alexanderhay2020/499/schedule.md

### Week 1<br>
<sup>1/5 - 1/11</sup>

Actuator research

### Week 2<br>
<sup>1/12 - 1/18</sup>

**COMPLETED**<br>
* Purchased actuators (x2) ETA 1/20
* Contacted manf. for part model, received .STEP 1/15
* Installed VM + Solidworks 1/16
* Initial sketch & math

**TO DO**<br>
* Begin CAD model

### Week 3<br>
<sup>1/19 - 1/25</sup>

**GOAL**
* Test actuator
* Begin CAD model

**COMPLETED**
* Test Actuator
* Initial CAD model

**IN PROGRESS**
* Refining CAD Model

**TO DO**
* Test 2 actuators

### Week 4<br>
<sup>1/26 - 2/1</sup>

**GOAL**
* Test actuator
* Continue CAD model

**COMPLETED**
* Ordering

**IN PROGRESS**
* Refining CAD Model
* Testing

###### Reach
design elbow angle detector

### Week 5<br>
<sup>2/2 - 2/8</sup>

**GOAL**
* Research rotary encoders
* CAD redesign for laser cutter
* Laser cutter training

**COMPLETED**
* Ordered rotary encoder
* Laser cutter training

**IN PROGRESS**
* Mechanical design - elbow

###### Reach
collect EMG data from myo

### Week 6<br>
<sup>2/9 - 2/15</sup>

note: EMG aspect scraped

**GOAL**
 * GET IT TO MOVE
 * Fix shorting issue

**COMPLETED**
 * Bearing install
 * Shaft install
 * Replaced rotary encoder (ordered wrong one)

 **IN PROGRESS**
 * Shaft collar design
 * Actuator/Collar connection
 * Lengthen frame to fit bicep/brac

### Week 7<br>
<sup>2/16 - 2/22</sup>

**GOAL**
 * Get it to move

**COMPLETED**
 * Frame lengthened
 * Hardware replaced to accommodate new material & manf. process
 * Replaced washers with plastic spacers (shorting issue)
 * Got it to move

**IN PROGRESS**
* Power Supply
* Actuator/Collar connection
* Replace rotary encoder (digikey mislabeled)

### Week 8<br>
<sup>2/23 - 2/29</sup>

**GOAL**
 * Create Circuit Diagram
 * Find Power Supply
 * Update github/portfolio

**COMPLETED**
 * Circuit Diagram
 * Ordered Power Supply

**IN PROGRESS**
* Actuator/Collar connection
* Rotary encoder redesign

### Week 10<br>
<sup>3/1 - 3/7</sup>

note: dropped rotary encoder aspect

**GOAL**
  * Actuator/Collar connection

**COMPLETED**
  * Actuator/Collar connection (turnbuckle)
  * Frame redesign for MSI day

**IN PROGRESS**
  * Attachment

**TO-DO**
  * Finalize project

### Week 11<br>
<sup>3/8 - 3/14</sup>

COVID-19

### Week 12<br>
<sup>3/15 - 3/21</sup>

COVID-19
