alexanderhay2020/499/(commit log)

2020-01-16 schedule framework
2020-03-14 coupled muscles and fans created flex/relax functions
2020-03-15 BOM LINK
2020-08-01 PIC communicates with screen and relay board. ADC still in works.
2020-08-04 ADC functions work, I think. Need to test
